KevinOConnor/zipspool/stl/carriage.stl

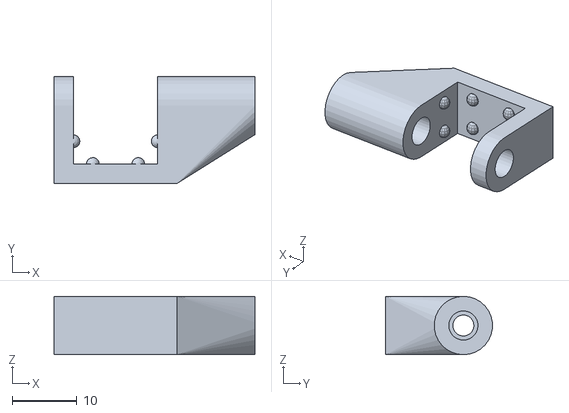
[picture p2: CAD file, 2020-12-20]
stl/carriage.stl
31.0 x 16.5 x 9.00
