KevinOConnor/zipspool/stl/clip-wide.stl

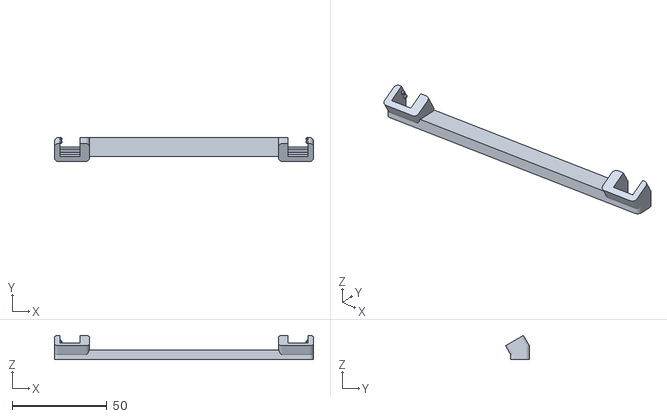
[picture p3: CAD file, 2020-12-20]
stl/clip-wide.stl
137.0 x 12.7 x 12.9
