KevinOConnor/zipspool/stl/clip.stl

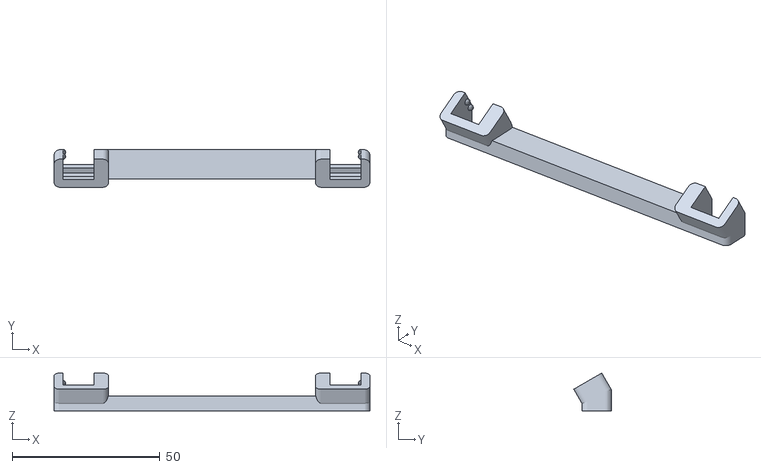
[picture p4: CAD file, 2020-12-20]
stl/clip.stl
107.0 x 12.7 x 12.9
