KevinOConnor/zipspool/stl/holder.stl

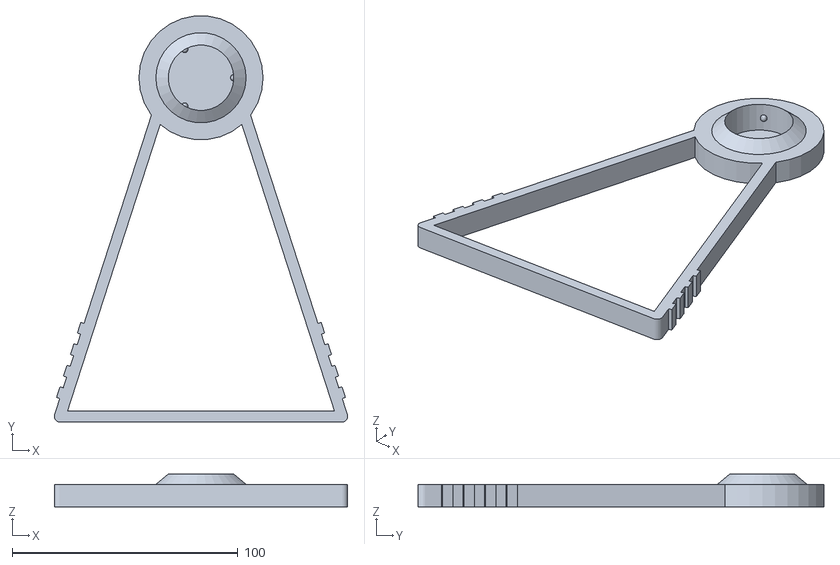
[picture p5: CAD file, 2020-11-18]
stl/holder.stl
130.0 x 179.8 x 14.6
