KevinOConnor/zipspool/stl/holder-short.stl

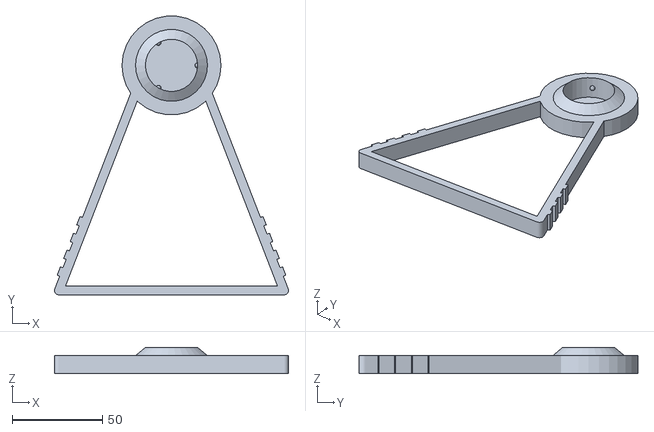
[picture p6: CAD file, 2020-11-18]
stl/holder-short.stl
130.0 x 154.8 x 14.6
