KevinOConnor/zipspool/stl/spindle.stl

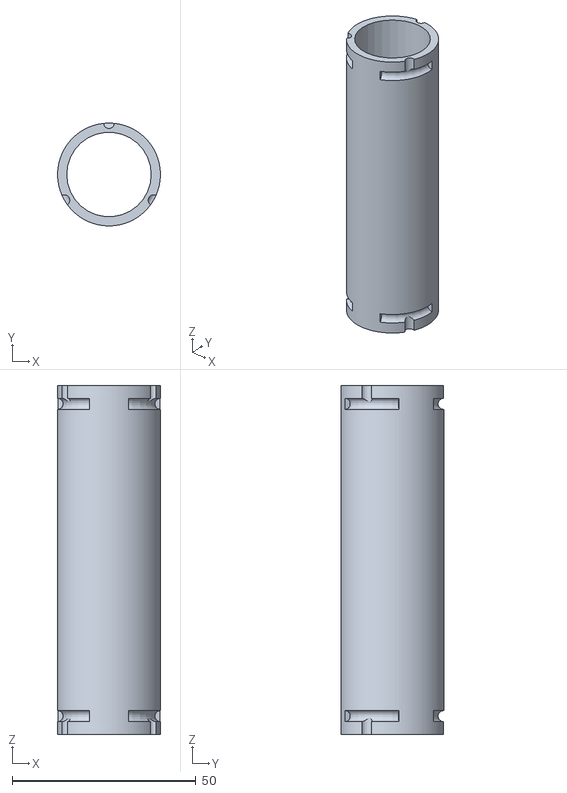
[picture p7: CAD file, 2019-01-28]
stl/spindle.stl
28.0 x 28.0 x 95.0
