KevinOConnor/zipspool/stl/spindle-wide.stl

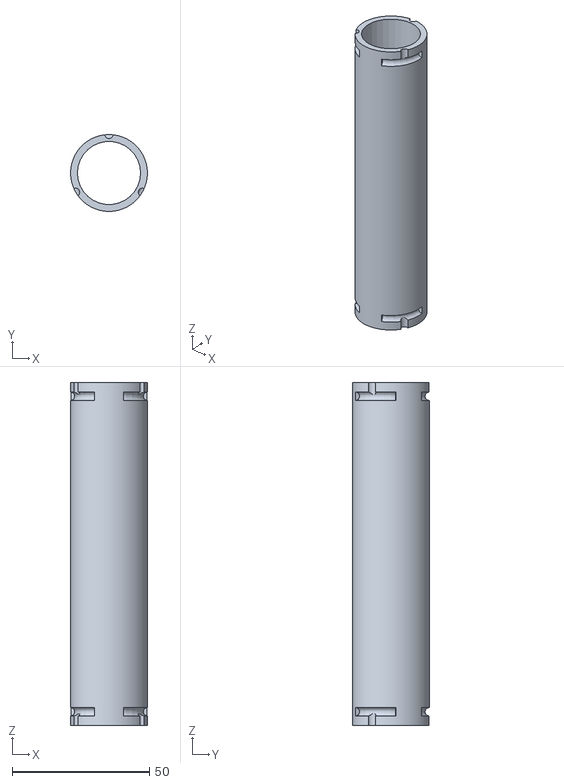
[picture p8: CAD file, 2019-01-28]
stl/spindle-wide.stl
28.0 x 28.0 x 125.0
