KevinOConnor/zipspool/(commit log)

2019-01-28 Add initial zipspool scad files
    [zipspool.scad]
2019-01-28 stl: Add initial STL files
    [clip-wide.stl, clip.stl, holder-tall.stl, holder.stl, spindle-wide.stl, spindle.stl]
2019-10-15 stl: Fix typo in README file
2020-11-18 zipspool: Declare $fs=.5 globally
    [zipspool.scad]
2020-11-18 zipspool: Rework clip for ptfe tube on both sides
    [zipspool.scad]
2020-11-18 zipspool: Add additional clip holder along side of base
    [zipspool.scad]
2020-11-18 zipspool: Increase default height from 155 to 180
    [zipspool.scad]
2020-11-18 zipspool: Remove unneeded echo() statements
    [zipspool.scad]
2020-11-18 zipspool: Optimize spindle rendering by using angle parameter of rotate_extrude
    [zipspool.scad]
2020-11-18 zipspool: Use varying diameter for spindle
    Use a varying diameter on the spindle to reduce friction by reducing
    contact area between spool and spindle.
    [zipspool.scad]
2020-11-18 stl: Update stl files and docs to latest
    [clip-wide.stl, clip.stl, holder-short.stl, holder-tall.stl, holder.stl]
2020-12-02 docs: Recommend 3mm internal diameter ptfe tubing
    Update the docs to recommend using 3mm id / 4mm od ptfe tubing. That
    tubing has notably less friction and provides better visibility of the
    filament in the tube.
2020-12-20 zipspool: New filament guide and clip
    The existing clip forced the filament to unravel towards the center of
    the clip. This caused additional friction and could cause the
    filament to become crimped on its way into the filament guide.
    Replace with a new clip and carriage system. The carriage is designed
    to alow the filament to pull straight from the spool.
    [zipspool.scad]
2020-12-20 docs: Update instructions and stl files with new carriage on clip system
    [carriage.stl, clip-wide.stl, clip.stl]
